umts/neopixel-6-display-controller/BOM_neopixel-6-display-controller.xlsx

No. | Quantity | Comment | Designator | Footprint | Value | Manufacturer Part | Manufacturer | Supplier Part | Supplier
1 | 1 | 10uF | C1 | C1210 | 10uF | CL32B106KAJNNNE | SAMSUNG(三星) | C39232 | LCSC
2 | 5 | 100nF | C2,C5,C6,C8,C9 | C1206 | 100nF | 1206N104J500CT | Walsin(华新科) | C170182 | LCSC
3 | 2 | 22uF | C3,C4 | C1210 | 22uF | CL32B226KAJNNNE | SAMSUNG(三星) | C309062 | LCSC
4 | 1 | 1nF | C10 | C0402 | 1nF | GRM1555C1H102JA01D | muRata(村田) | C76947 | LCSC
5 | 1 | DB2EVC-3.81-4P-GN | CN1 | CONN-TH_4P-P3.81_DB2EVC-3.81-4P |  | DB2EVC-3.81-4P-GN | DORABO(地博电气) | C395697 | LCSC
6 | 1 | KF250T-5.0-2*6P | CN2 | CONN-TH_KF250T-5.0-2X6P |  | KF250T-5.0-2*6P | KEFA(科发) | C976540 | LCSC
7 | 6 | DB2EVC-3.81-2P-GN | CN3,CN4,CN5,CN6,CN7,CN8 | CONN-TH_2P-P3.81_DB2EVC-3.81-2P-BK |  | DB2EVC-3.81-2P-GN | DORABO(地博电气) | C395686 | LCSC
8 | 1 | ESDA6V1U1RL | D1 | SO-8_L4.9-W3.9-P1.27-LS5.9-BL |  | ESDA6V1U1RL | ST(意法半导体) | C118278 | LCSC
9 | 7 | MF-MSMF110/16-2 | F1,F2,F3,F4,F5,F6,F7 | F1812 |  | MF-MSMF110/16-2 | BOURNS | C210834 | LCSC
10 | 1 | A2541HWV-12P | H1 | HDR-TH_12P-P2.54-V-F |  | A2541HWV-12P | CJT(长江连接器) | C5340512 | LCSC
11 | 1 | ZX-PM2.54-1-16PY | H2 | HDR-TH_16P-P2.54-V-F-A |  | ZX-PM2.54-1-16PY | Megastar(兆星) | C7499334 | LCSC
12 | 1 | JL141V-25404GA1 | H3 | CONN-TH_4P-P2.54_JILN_JL141V-25404GA1 |  | JL141V-25404GA1 | JILN(锦凌) | C2922621 | LCSC
13 | 1 | X6511WVS-03H-C60D48R2 | H4 | HDR-SMD_3P-P2.54_XKB_X6511WVS-03H-C60D48R2 |  | X6511WVS-03H-C60D48R2 | XKB Connection(中国星坤) | C2883760 | LCSC
14 | 1 | 4.7uH | L1 | IND-SMD_L7.0-W7.0_CDRR7D45T125NP | 4.7uH | CDRR7D45T125NP-4R7MC | Sumida(胜美达) | C171616 | LCSC
15 | 1 | 2N7002KQ-13 | Q1 | SOT-23-3_L2.9-W1.3-P1.90-LS2.4-BR |  | 2N7002KQ-13 | DIODES(美台) | C526325 | LCSC
16 | 6 | 100Ω | R1,R2,R3,R4,R5,R6 | R0805 | 100Ω | ERA6AEB101V | PANASONIC(松下) | C445646 | LCSC
17 | 2 | 0Ω | R8,R9 | R0805 | 0Ω | RTT050000FTP | RALEC(旺诠) | C103900 | LCSC
18 | 1 | 12kΩ | R10 | R0805 | 12kΩ | PTFR0805B12K0N9 | RESI(开步睿思) | C351614 | LCSC
19 | 1 | 1.78Ω | R11 | R0805 | 1.78Ω | TR0805D1R78P0525 | EVER OHMS(天二科技) | C149982 | LCSC
20 | 1 | 3.09Ω | R12 | R0805 | 3.09Ω | WR08W3R09FTL | Walsin(华新科) | C367858 | LCSC
21 | 1 | 470Ω | R13 | R0402 | 470Ω | ERA2AEB471X | PANASONIC(松下) | C445590 | LCSC
22 | 1 | KNTC0805/10KJ3450 | R14 | R0805 | 10k | KNTC0805/10KJ3450 | KUU | C2892551 | LCSC
23 | 1 | 1kΩ | R15 | R0805 | 1kΩ | ERJ-HP6F1001V | PANASONIC(松下) | C4264406 | LCSC
24 | 2 | SS12D10G4 071 | SW1,SW2 | SW-TH_SHOU-HAN_SS12D10G4 |  | SS12D10G4 071 | SHOU HAN(首韩) | C2887259 | LCSC
25 | 1 | SN74LV4051ATPWRQ1 | U1 | TSSOP-16_L5.0-W4.4-P0.65-LS6.4-BL |  | SN74LV4051ATPWRQ1 | TI(德州仪器) | C882802 | LCSC
26 | 1 | SN74HCS365PWR | U2 | TSSOP-16_L5.0-W4.4-P0.65-LS6.4-BL |  | SN74HCS365PWR | TI(德州仪器) | C2868026 | LCSC
27 | 1 | AP63205WU-7 | U3 | TSOT-23-6_L2.9-W1.6-P0.95-LS2.8-BL |  | AP63205WU-7 | DIODES(美台) | C2071056 | LCSC
28 | 3 | PESD3V3L2BT-ES | U4,U5,U6 | SOT-23-3_L2.9-W1.3-P0.95-LS2.4-BR |  | PESD3V3L2BT-ES | ElecSuper(静芯微) | C5180242 | LCSC
29 | 1 | AL5801W6Q-7 | U7 | SOT-26-6_L3.0-W1.6-P0.95-LS2.8-BL |  | AL5801W6Q-7 | DIODES(美台) | C2678629 | LCSC
30 | 1 | TXS0102DCUR | U8 | VSON8_L2.0-W2.3-P0.50-LS3.1-BL |  | TXS0102DCUR | TI(德州仪器) | C53434 | LCSC
