umts/neopixel-6-display-controller/SCH_neopixel-6-display-controller.pdf

# A4 10 Y5 11 A5 12 Y6 13 A6 14 OE2# 15 VCC 16

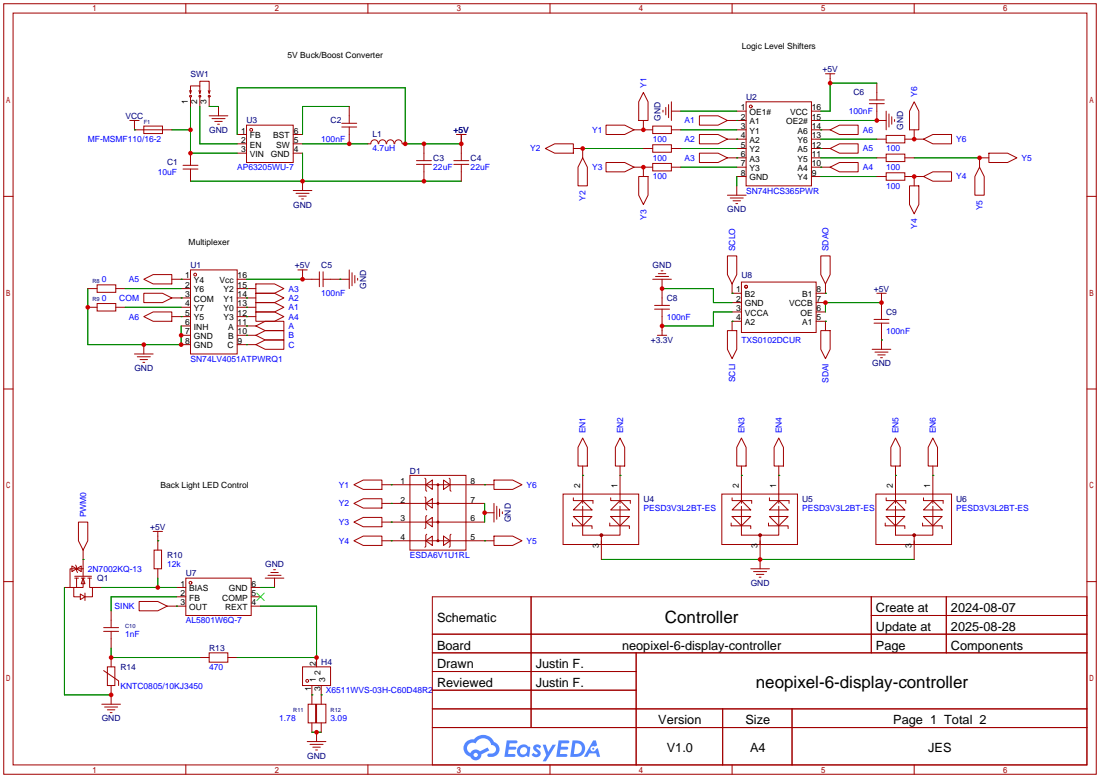
[picture p2: page 1]

Back Light LED Control

Schematic | Controller | Create at | 2024-08-07

Update at | 2025-08-28

Board | neopixel-6-display-controller | Page | Components
Drawn | Justin F. | neopixel-6-display-controller
Reviewed | Justin F.

Version | Size | Page 1 Total 2
V1.0 | A4 | JES

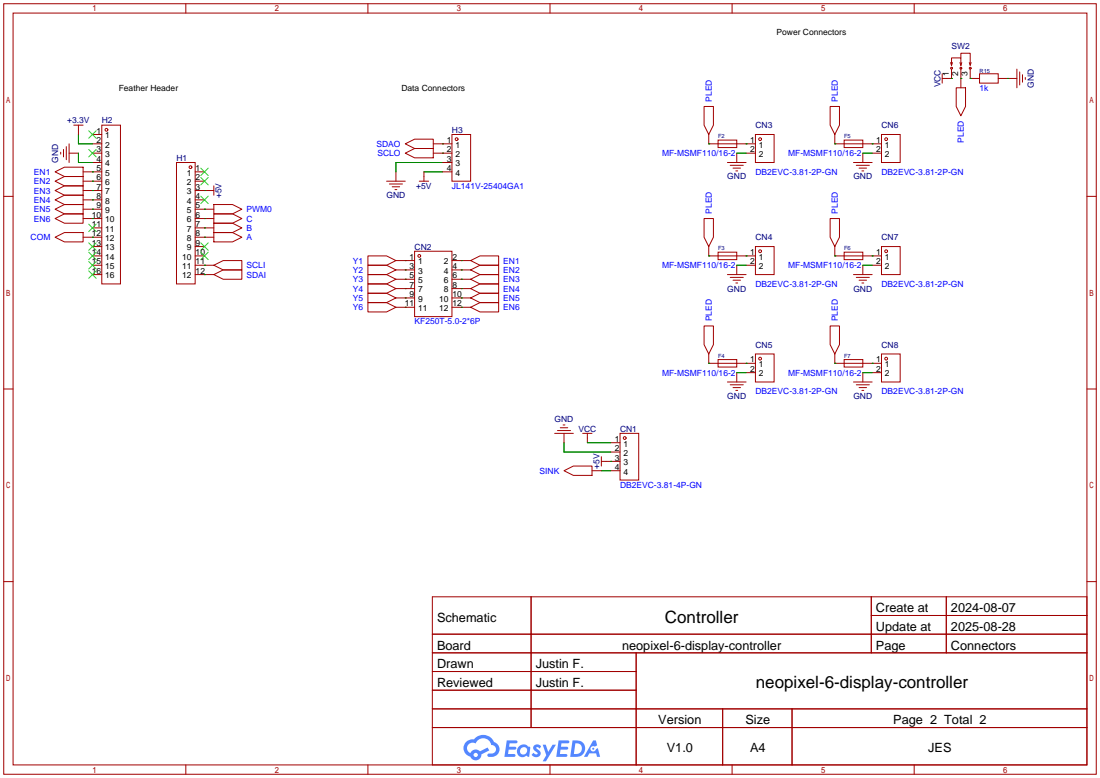
[picture p3: page 2]

Schematic | Controller | Create at | 2024-08-07

Update at | 2025-08-28

Board | neopixel-6-display-controller | Page | Connectors
Drawn | Justin F. | neopixel-6-display-controller
Reviewed | Justin F.

Version | Size | Page 2 Total 2
V1.0 | A4 | JES
