umts/neopixel-6-display-controller/departure_board_controller.pdf

# A4 10 Y5 11 A5 12 Y6 13 A6 14 OE2# 15 VCC 16

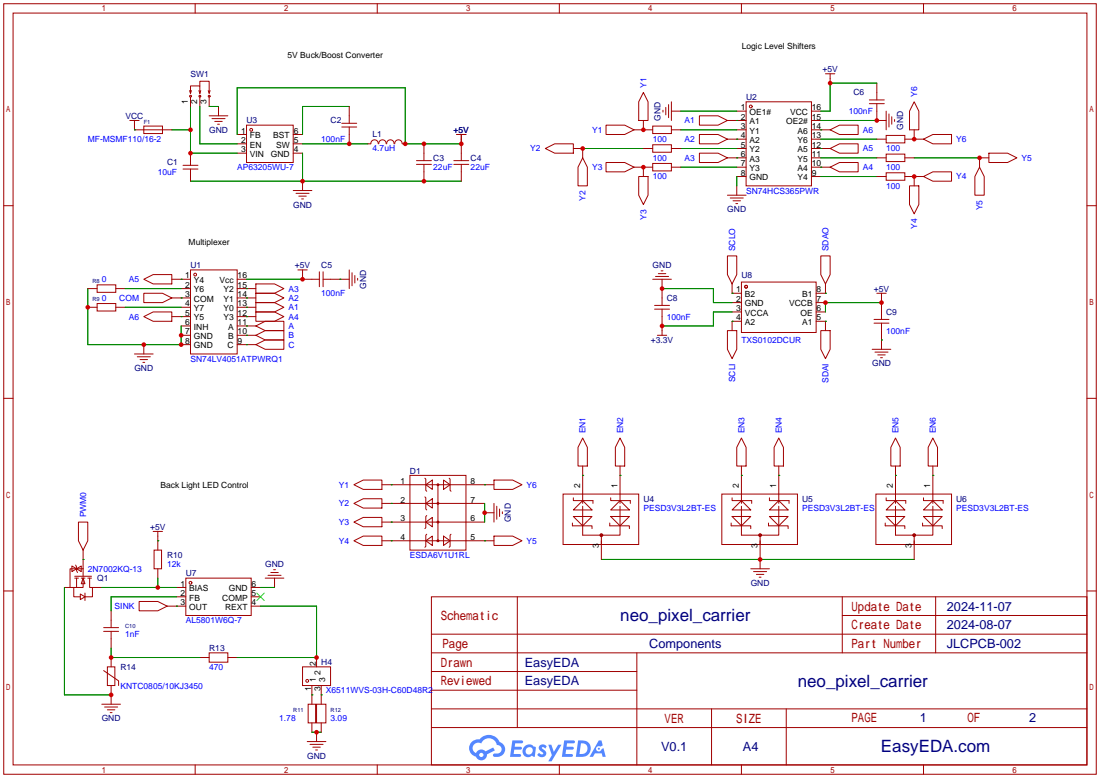
[picture p4: page 1]

Back Light LED Control

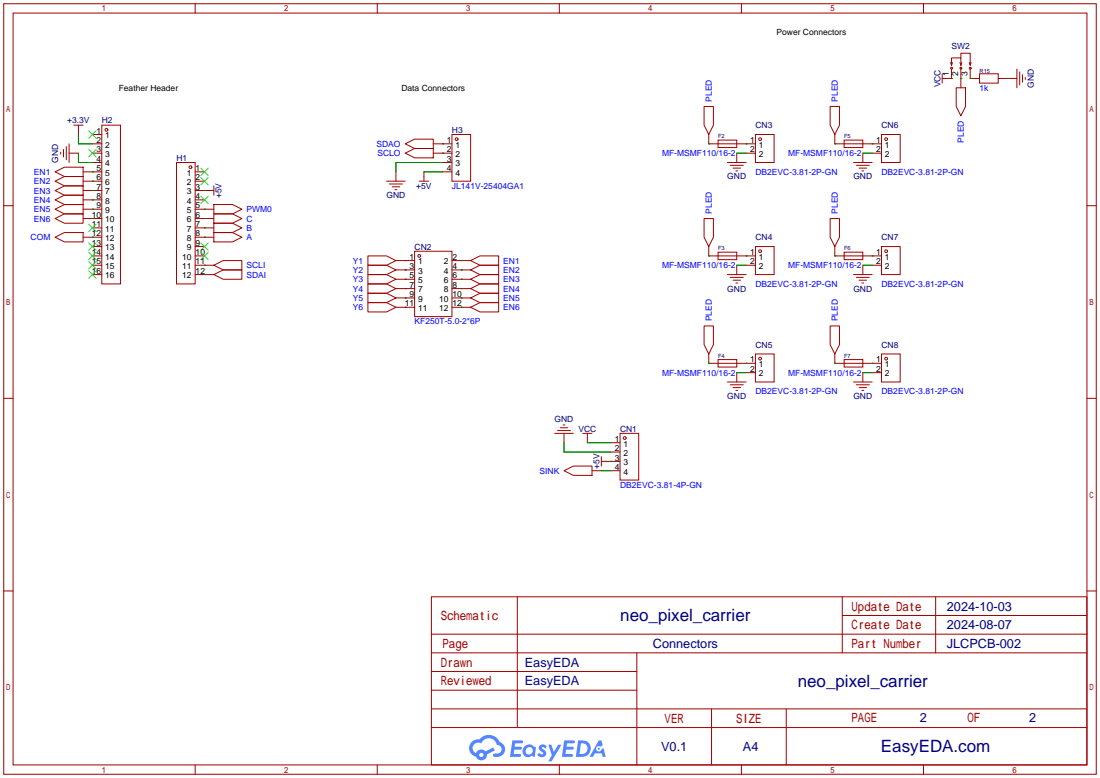
[picture p5: page 2]
