umts/neopixel-6-display-controller/(list of files, drawings)

Other design files:
neopixel-6-display-controller.epro
