umts/neopixel-6-display-controller/(commit log)

2025-08-27 Initial release
    [BOM_departure_board_controller.xlsx, departure_board_controller.epro, departure_board_controller_pick_and_place.xlsx]
2025-08-28 Add README and fix 3D model
    [departure_board_controller.epro, departure_board_controller_pick_and_place.xlsx]
2025-08-28 Rename project
    [BOM_departure_board_controller.xlsx, BOM_neopixel-6-display-controller.xlsx, PickAndPlace_neopixel-6-display-controller.xlsx, departure_board_controller.epro, departure_board_controller_pick_and_place.xlsx, neopixel-6-display-controller.epro]
